rchampeimont/arduino_computer_monitor/(commit log)

2021-06-01 Use pull-up resistor for HDD LED
2021-06-02 Use pin A5 to minimize interferences with A0
    [computer_monitor.ino]
2021-06-03 fix misleading variable name
    [computer_monitor.ino]
2021-06-03 fix mistake in comment
    [lcd_custom_chars.ino]
